CDurbala/streetlighting/LaTeX source/cls/gls.tex

\newglossaryentry{computer}
{
  name=computer,
  description={is a programmable machine that receives input,
               stores and manipulates data, and provides
               output in a useful format}
}

\newacronym[longplural={Frames per Second}]{fpsLabel}{FPS}{Frame per Second}
\newacronym{rtos}{RTOS}{Real-Time Operating System}
\newacronym{lcd}{LCD}{Liquid Crystal Display}

\newacronym{pwm}{PWM}{Pulse-Width Modulation}
