CDurbala/streetlighting/LaTeX source/pics/diag_context.jpg

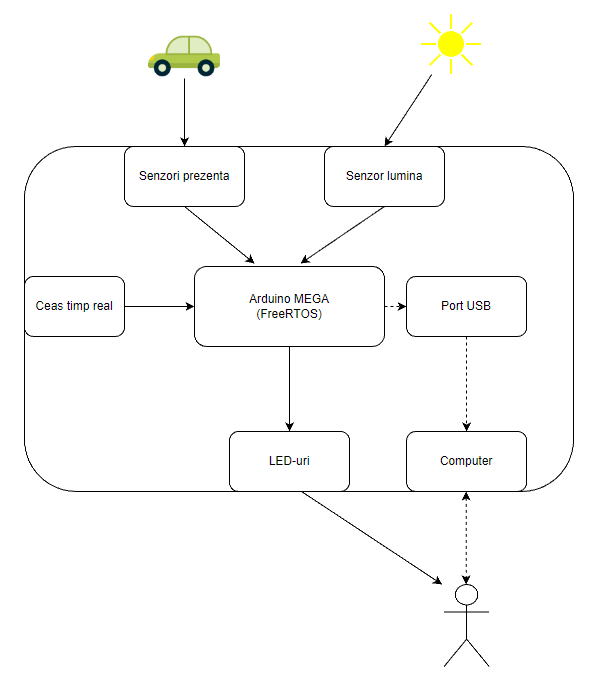
LaTeX source/pics/diag_context.jpg
