CDurbala/streetlighting/LaTeX source/pics/diagrama task-uri.jpg

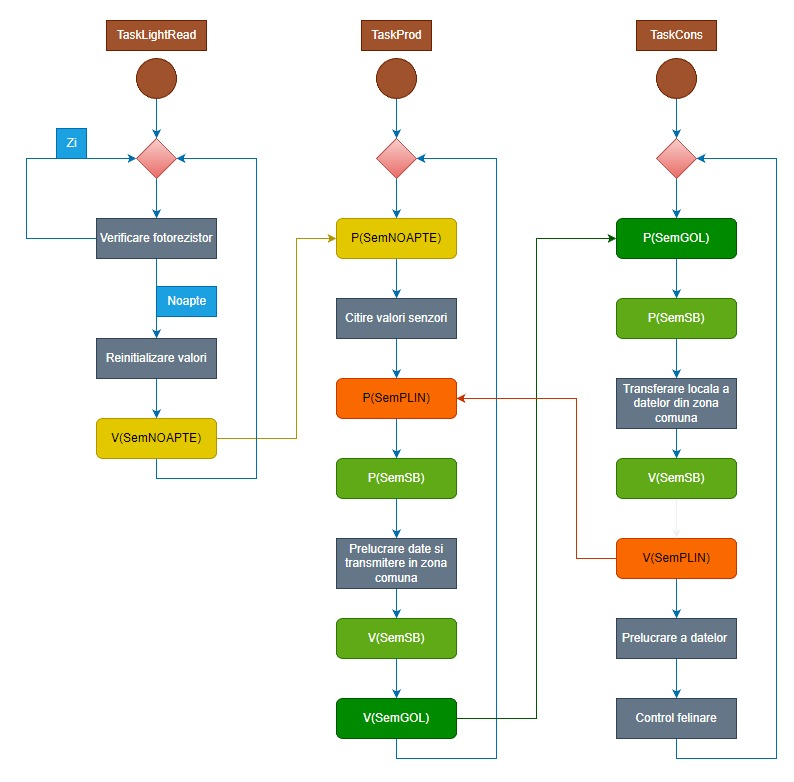
LaTeX source/pics/diagrama task-uri.jpg
