CDurbala/streetlighting/LaTeX source/pics/diag_context.drawio.pdf

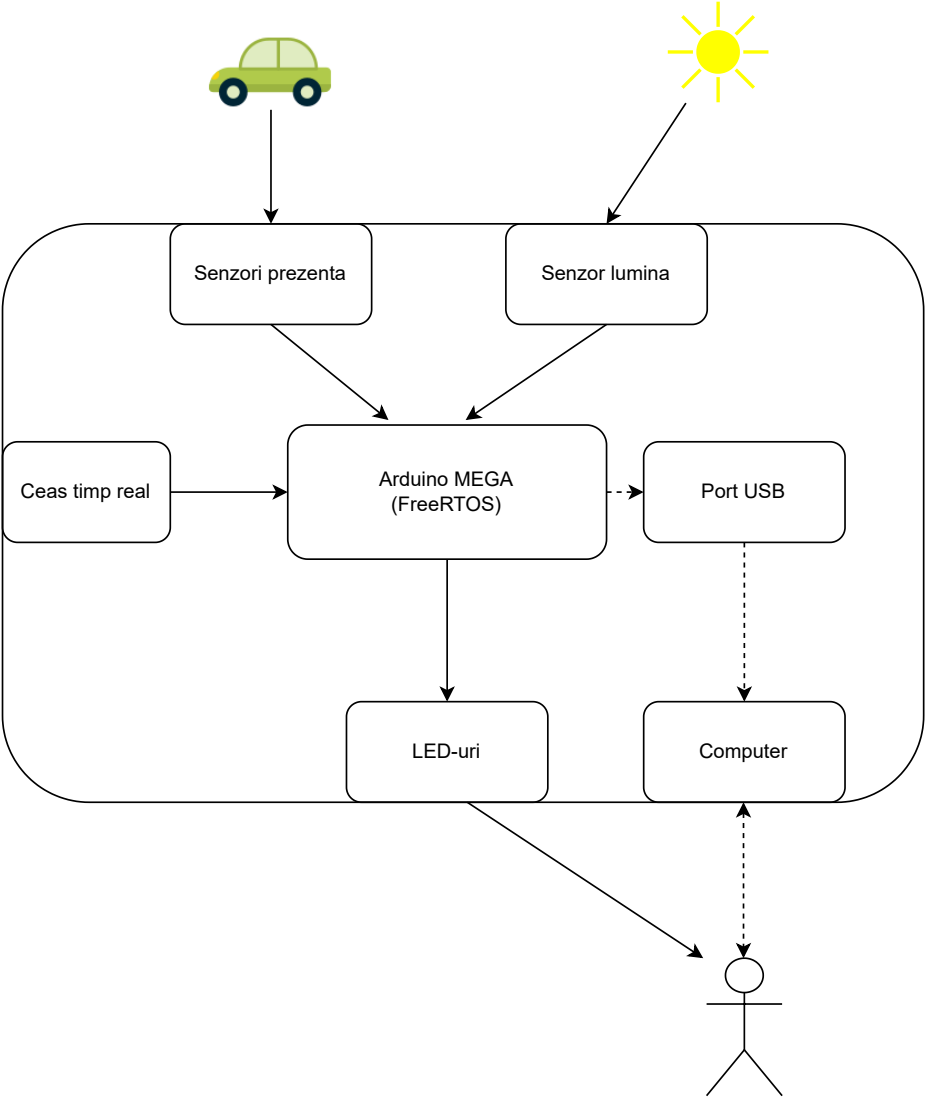
[picture p30: page 1]
Senzori prezenta; Arduino MEGA; Senzor lumina; LED-uri; Port USB; Computer

(FreeRTOS) Ceas timp real
