CDurbala/streetlighting/LaTeX source/pics/diag_context2.drawio.pdf

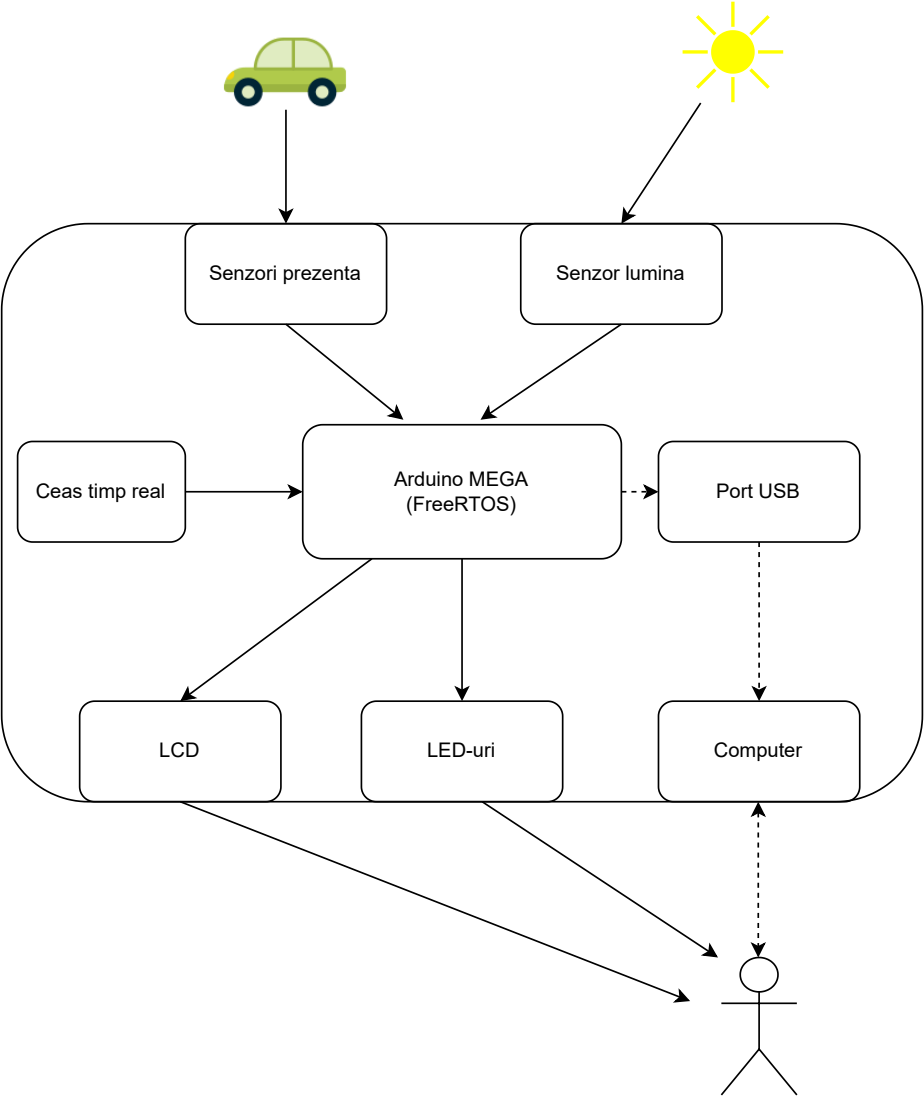
[picture p31: page 1]
Senzori prezenta; Arduino MEGA; Senzor lumina; LED-uri; Port USB; LCD; Computer

(FreeRTOS) Ceas timp real
