CDurbala/streetlighting/LaTeX source/pics/diag.drawio.pdf

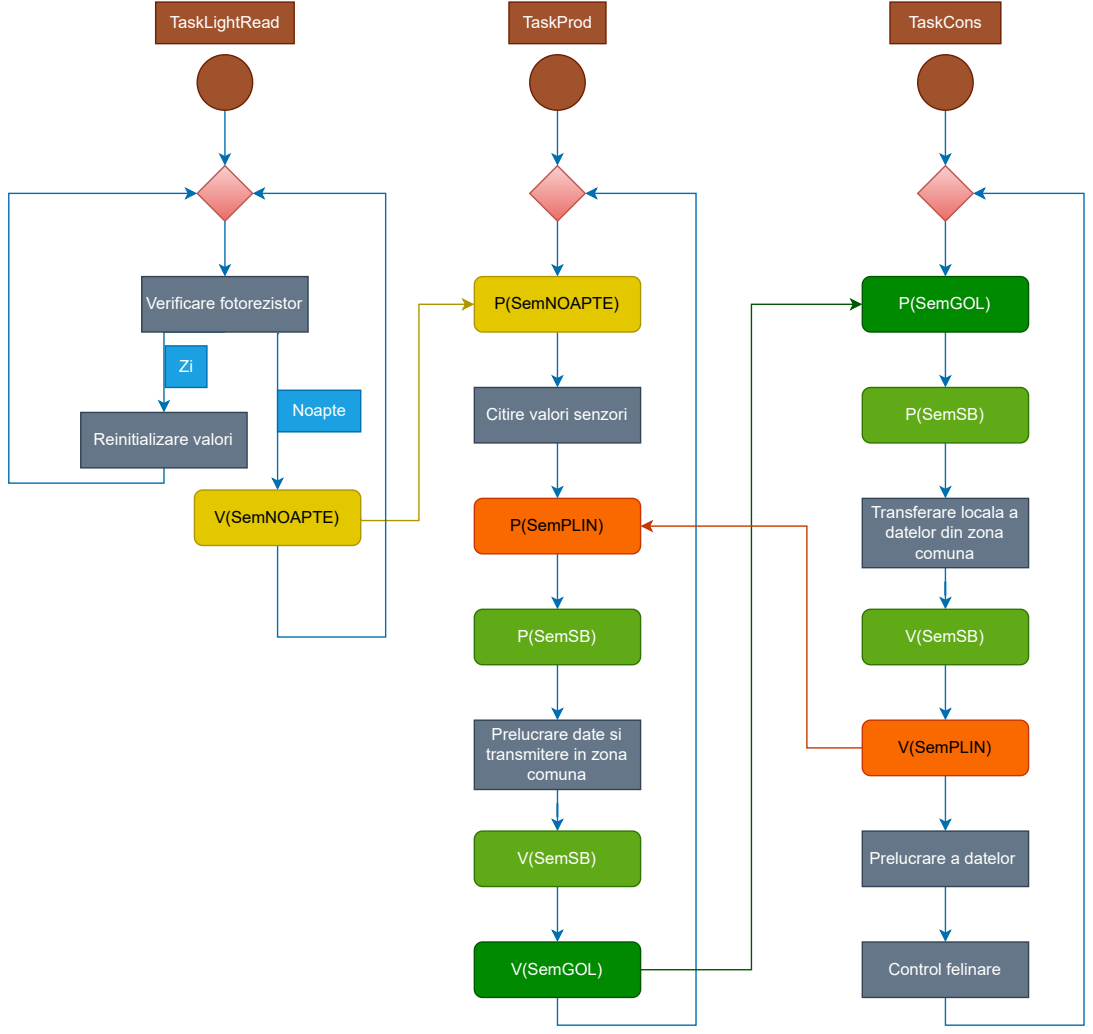
[picture p32: page 1]
Verificare fotorezistor; Reinitializare valori; TaskLightRead; V(SemNOAPTE); P(SemNOAPTE); P(SemPLIN); P(SemSB); V(SemGOL); V(SemSB); P(SemGOL); V(SemPLIN); Prelucrare a datelor; Control felinare; TaskProd; TaskCons

Noapte | Citire valori senzori

Transferare locala a
datelor din zona
comuna

Prelucrare date si
transmitere in zona
