CDurbala/streetlighting/LaTeX source/pics/diag2.drawio.pdf

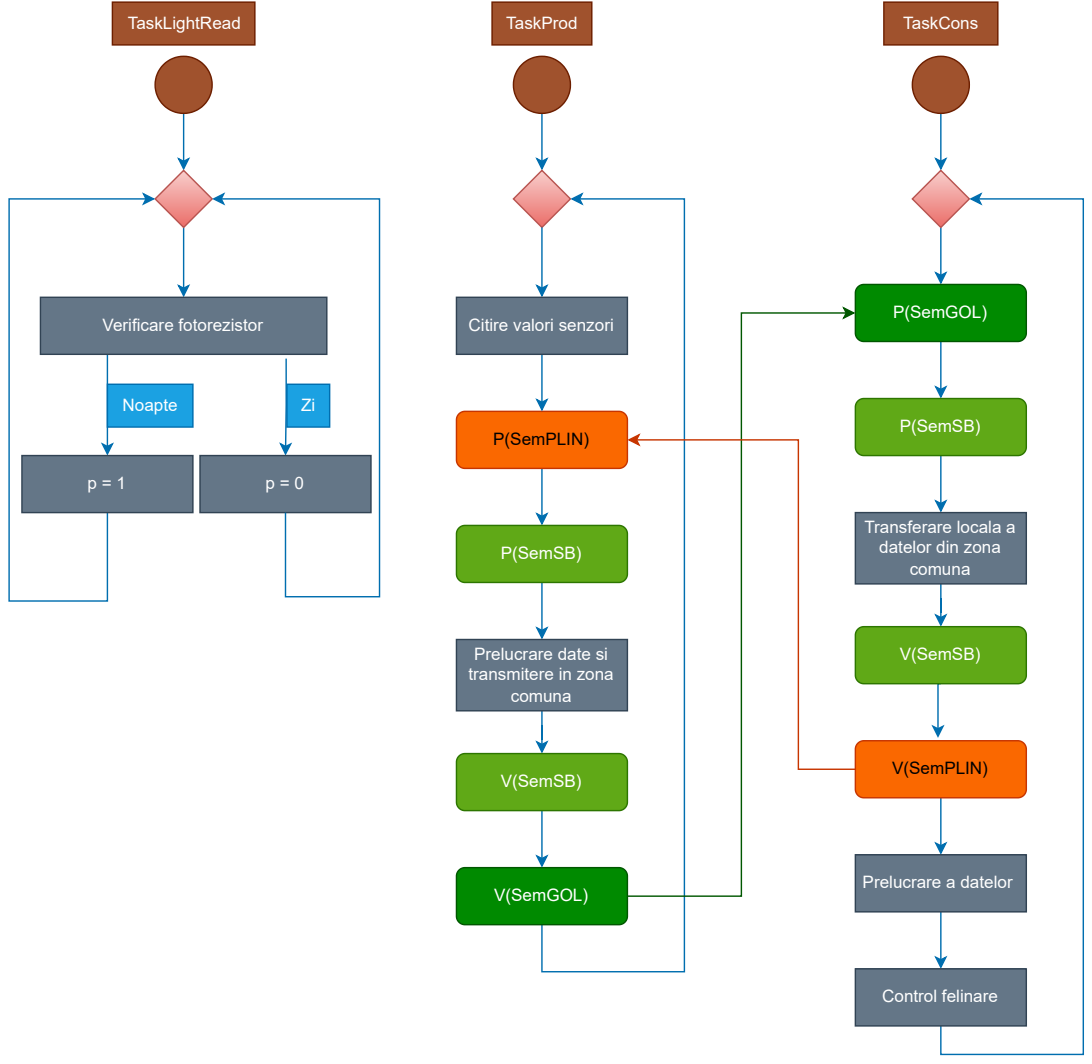
[picture p33: page 1]
Verificare fotorezistor; Noapte; TaskLightRead; P(SemPLIN); P(SemSB); V(SemGOL); V(SemSB); P(SemGOL); V(SemPLIN); Prelucrare a datelor; Control felinare; TaskProd; TaskCons

Citire valori senzori

Transferare locala a datelor din zona comuna

Prelucrare date si
transmitere in zona
comuna
