CDurbala/streetlighting/LaTeX source/pics/TaskLCD.drawio.pdf

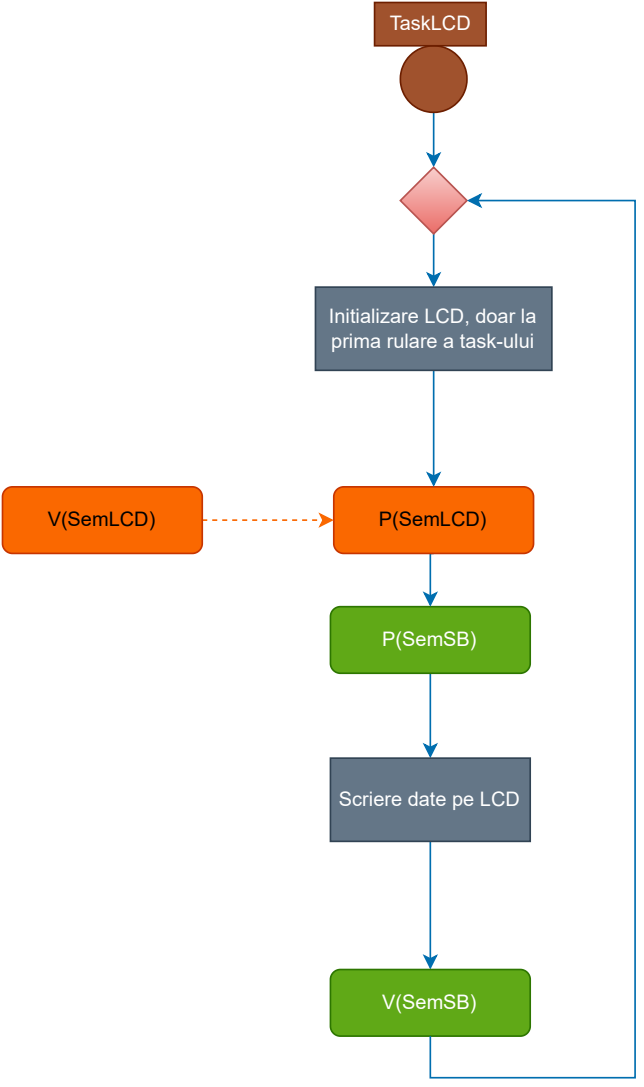
[picture p34: page 1]
P(SemSB); V(SemSB); TaskLCD; P(SemLCD); V(SemLCD)

Initializare LCD, doar la
prima rulare a task-ului

Scriere date pe LCD
